FovenX3/test1/hardware/neopico-hd/neopico-hd.kicad_pcb

## KiCad design hardware/neopico-hd/neopico-hd.kicad_pcb (2026-02-03)

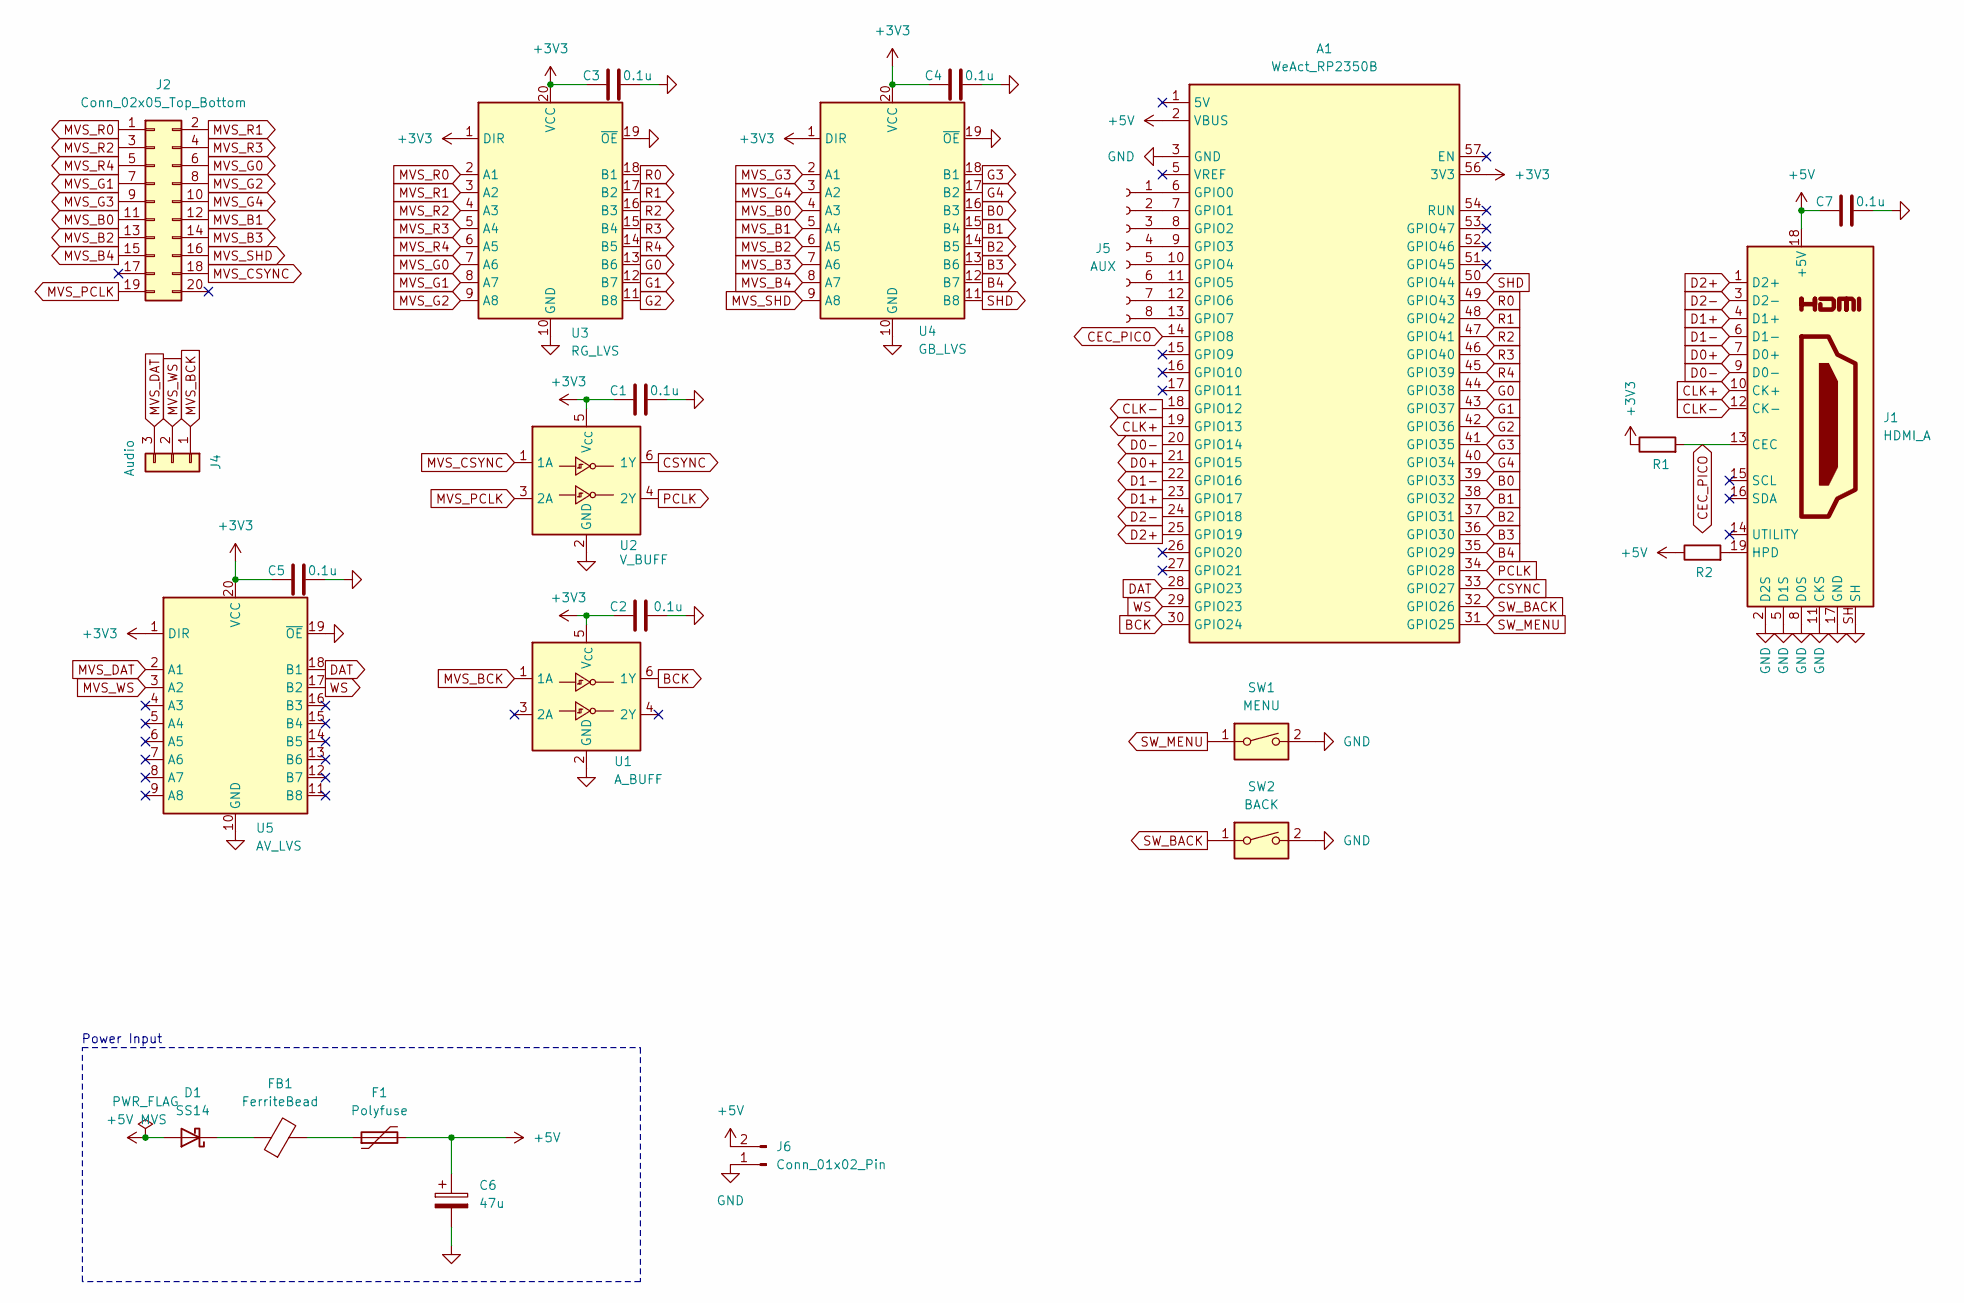
[picture p1: schematic neopico-hd.kicad_sch, NeoPico HD]

Parts:
A1: WeAct_RP2350B
C1, C2, C3, C4, C5, C7: 0.1u; C_0805_2012Metric_Pad1.18x1.45mm_HandSolder
C6: 47u; CP_Radial_D5.0mm_P2.00mm
D1: SS14; D_SMA
F1: Polyfuse; C_0805_2012Metric
FB1: FerriteBead; C_0805_2012Metric
J1: HDMI_A; HDMI_A_Molex_208658-1001_Horizontal
J2: Conn_02x05_Top_Bottom; IDC-Header_2x10_P2.54mm_Vertical
J4: Audio; JST_XA_B03B-XASK-1_1x03_P2.50mm_Vertical
J5: AUX; PinHeader_2x04_P2.54mm_Vertical
J6: Conn_01x02_Pin; PinHeader_1x02_P2.54mm_Vertical
R1: 27K; R_0805_2012Metric
R2: 10K; R_0805_2012Metric_Pad1.20x1.40mm_HandSolder
SW1: MENU; Samtec_HPM-02-01-x-S_Straight_1x02_Pitch5.08mm
SW2: BACK; Samtec_HPM-02-01-x-S_Straight_1x02_Pitch5.08mm
U1: A_BUFF; SOT-23-6
U2: V_BUFF; SOT-23-6
U3: RG_LVS; TSSOP-20_4.4x6.5mm_P0.65mm
U4: GB_LVS; TSSOP-20_4.4x6.5mm_P0.65mm
U5: AV_LVS; TSSOP-20_4.4x6.5mm_P0.65mm

Connections:
+3V3: A1.55 (3V3), A1.56 (3V3), C1.1, C2.1, C3.1, C4.1, C5.1, R1.1, U1.5 (V_{CC}), U2.5 (V_{CC}), U3.1 (DIR), U3.20 (VCC), U4.1 (DIR), U4.20 (VCC), U5.1 (DIR), U5.20 (VCC); also elsewhere on the board
+5V: A1.2 (VBUS), C6.1, C7.1, F1.2, J1.18 (+5V), J6.2, R2.1
+5V MVS: D1.2 (A)
B0: A1.39 (GPIO33), U4.16 (B3)
B1: A1.38 (GPIO32), U4.15 (B4)
B2: A1.37 (GPIO31), U4.14 (B5)
B3: A1.36 (GPIO30), U4.13 (B6)
B4: A1.35 (GPIO29), U4.12 (B7)
BCK: A1.30 (GPIO24), U1.6 (1Y)
CEC_PICO: A1.14 (GPIO8), J1.13 (CEC), R1.2
CLK+: A1.19 (GPIO13), J1.10 (CK+)
CLK-: A1.18 (GPIO12), J1.12 (CK-)
CSYNC: A1.33 (GPIO27), U2.6 (1Y)
D0+: A1.21 (GPIO15), J1.7 (D0+)
D0-: A1.20 (GPIO14), J1.9 (D0-)
D1+: A1.23 (GPIO17), J1.4 (D1+)
D1-: A1.22 (GPIO16), J1.6 (D1-)
D2+: A1.25 (GPIO19), J1.1 (D2+)
D2-: A1.24 (GPIO18), J1.3 (D2-)
DAT: A1.28 (GPIO23), U5.18 (B1)
G0: A1.44 (GPIO38), U3.13 (B6)
G1: A1.43 (GPIO37), U3.12 (B7)
G2: A1.42 (GPIO36), U3.11 (B8)
G3: A1.41 (GPIO35), U4.18 (B1)
G4: A1.40 (GPIO34), U4.17 (B2)
GND: A1.3 (GND), A1.4 (GND), A1.58 (GND), A1.59 (GND), A1.60 (GND), C1.2, C2.2, C3.2, C4.2, C5.2, C6.2, C7.2, J1.2 (D2S), J1.5 (D1S), J1.8 (D0S), J1.11 (CKS), J1.17 (GND), J1.SH, J6.1, SW1.2, SW2.2, U1.2 (GND), U2.2 (GND), U3.10 (GND), U3.19 (~OE), U4.10 (GND), U4.19 (~OE), U5.10 (GND), U5.19 (~OE)
MVS_B0: J2.11, U4.4 (A3)
MVS_B1: J2.12, U4.5 (A4)
MVS_B2: J2.13, U4.6 (A5)
MVS_B3: J2.14, U4.7 (A6)
MVS_B4: J2.15, U4.8 (A7)
MVS_BCK: J4.1, U1.1 (1A)
MVS_CSYNC: J2.18, U2.1 (1A)
MVS_DAT: J4.3, U5.2 (A1)
MVS_G0: J2.6, U3.7 (A6)
MVS_G1: J2.7, U3.8 (A7)
MVS_G2: J2.8, U3.9 (A8)
MVS_G3: J2.9, U4.2 (A1)
MVS_G4: J2.10, U4.3 (A2)
MVS_PCLK: J2.19, U2.3 (2A)
MVS_R0: J2.1, U3.2 (A1)
MVS_R1: J2.2, U3.3 (A2)
MVS_R2: J2.3, U3.4 (A3)
MVS_R3: J2.4, U3.5 (A4)
MVS_R4: J2.5, U3.6 (A5)
MVS_SHD: J2.16, U4.9 (A8)
MVS_WS: J4.2, U5.3 (A2)
unnamed: A1.6 (GPIO0), J5.1
unnamed: A1.7 (GPIO1), J5.2
unnamed: A1.8 (GPIO2), J5.3
unnamed: A1.9 (GPIO3), J5.4
unnamed: A1.10 (GPIO4), J5.5
unnamed: A1.11 (GPIO5), J5.6
unnamed: A1.12 (GPIO6), J5.7
unnamed: A1.13 (GPIO7), J5.8
unnamed: D1.1 (K), FB1.1
unnamed: F1.1, FB1.2
unnamed: J1.19 (HPD), R2.2
PCLK: A1.34 (GPIO28), U2.4 (2Y)
R0: A1.49 (GPIO43), U3.18 (B1)
R1: A1.48 (GPIO42), U3.17 (B2)
R2: A1.47 (GPIO41), U3.16 (B3)
R3: A1.46 (GPIO40), U3.15 (B4)
R4: A1.45 (GPIO39), U3.14 (B5)
SHD: A1.50 (GPIO44), U4.11 (B8)
SW_BACK: A1.32 (GPIO26), SW2.1
SW_MENU: A1.31 (GPIO25), SW1.1
WS: A1.29 (GPIO23), U5.17 (B2)

Notes on the sheet:
Power Input

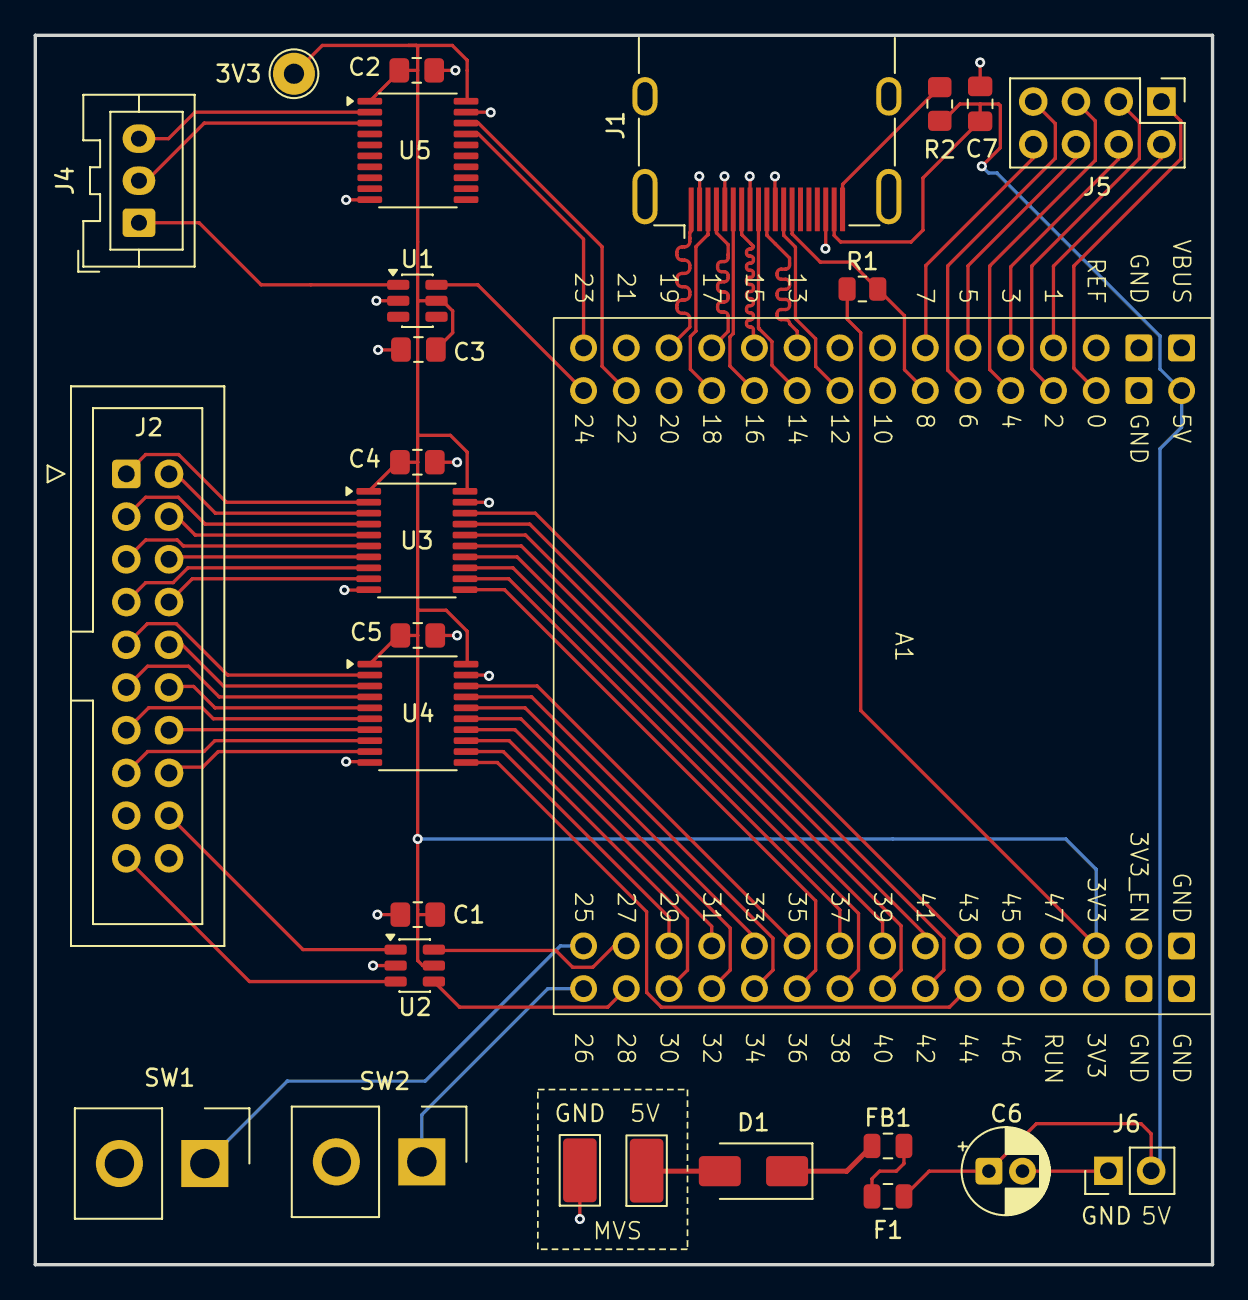
[picture p2: board neopico-hd.kicad_pcb from above]

Board: 2 copper layers, 70.0 x 73.1 mm, 26 parts (0 on the bottom side), 67 nets.

Other parts of the board:
3V3: TestPoint_THTPad_D2.5mm_Drill1.2mm

Their connections:
+3V3: 3V3.1; also elsewhere on the board
