FovenX3/test1/(commit log)

2025-11-29 Fix deploy. Adjust H offiset
    [main.c]
2025-11-29 Pico2 + full-frame grayscale working
2025-11-30 Simplify DVI capture using N64-style architecture
    - Single framebuffer instead of double buffering (accepts tearing)
    - Scanline callback for independent DVI output on Core 1
    - Blocking capture loop on Core 0, decoupled from DVI timing
    - Much more stable vertical positioning
    - Tuned offsets: H_ACTIVE_START=27, v_blanking_offset=16
    Inspired by PicoDVI-N64 and cps2_digiav reference implementations.
2025-11-30 240p capture, not horizontal glitching!
    [main_dvi.c]
2025-12-02 WIP Audio
    [neopico-hd.kicad_pcb, neopico-hd.kicad_sch]
2025-12-16 Fix DVI pin config for RP2350 protoboard wiring
    - Update neopico_config.h with correct pin mapping (CLK=GP31-32, TMDS=GP25-30)
    - Add pio_set_gpio_base() for GP32 access and DVI_USE_PIO_CLOCK for odd clock pin
    - Use shared config in main.c instead of duplicate definition
    - Add DVI_USE_PIO_CLOCK=1 to all DVI targets in CMakeLists.txt
    [main.c]
2025-12-18 Even better audio, intro voice broken.
    [audio_pipeline.c, audio_pipeline.h, i2s_capture.c, i2s_capture.h, src.c, src.h]
2025-12-28 Update schematics
    [neopico-hd.kicad_sch]
2026-01-10 Revert "Fix HDMI signal timing, polarity and signal integrity for strict receivers"
    This reverts commit fcc4ab38192a075e14860dfe8f420e572237ec3e.
    [audio_subsystem.c, main.c, src.h]
2026-01-10 Improve audio hiccup issue
    [audio_subsystem.c]
2026-01-11 V1 PCB
    [neopico-hd.kicad_pcb, neopico-hd.kicad_sch]
2026-01-13 Update hardware
    [neopico-hd.kicad_pcb, neopico-hd.kicad_sch]
2026-01-27 Update pico_hdmi: add DVI/HDMI mode toggle
    Adds runtime switching between DVI mode (no Data Islands, max compat)
    and HDMI mode (with audio). Fixes sync issues on some monitors.
2026-02-03 Update pins mapping to match the custom PCB
    [neopico-hd.kicad_sch]
